k2OS/NoWaterNoNo/README.md

<h1>No Water, No No</h1>
See https://labitat.dk/wiki/No_Water_No_No for more information.

Eagle/ contains eagle files for the PCB

OpenSCAD/ contains the OpenSCAD drawings for the mounting brackets for the nodes + the battery compartment.

NoWaterNoNo/ contains the software for the nodes.
