k2OS/NoWaterNoNo/(list of files, cad)

Other CAD files:
OpenSCAD/nowaterholder_v4.scad
OpenSCAD/nowaterholder_v5.scad
