k2OS/NoWaterNoNo/Eagle/NoWaterNoNo.brd

## EAGLE design Eagle/NoWaterNoNo.brd (2014-10-13)

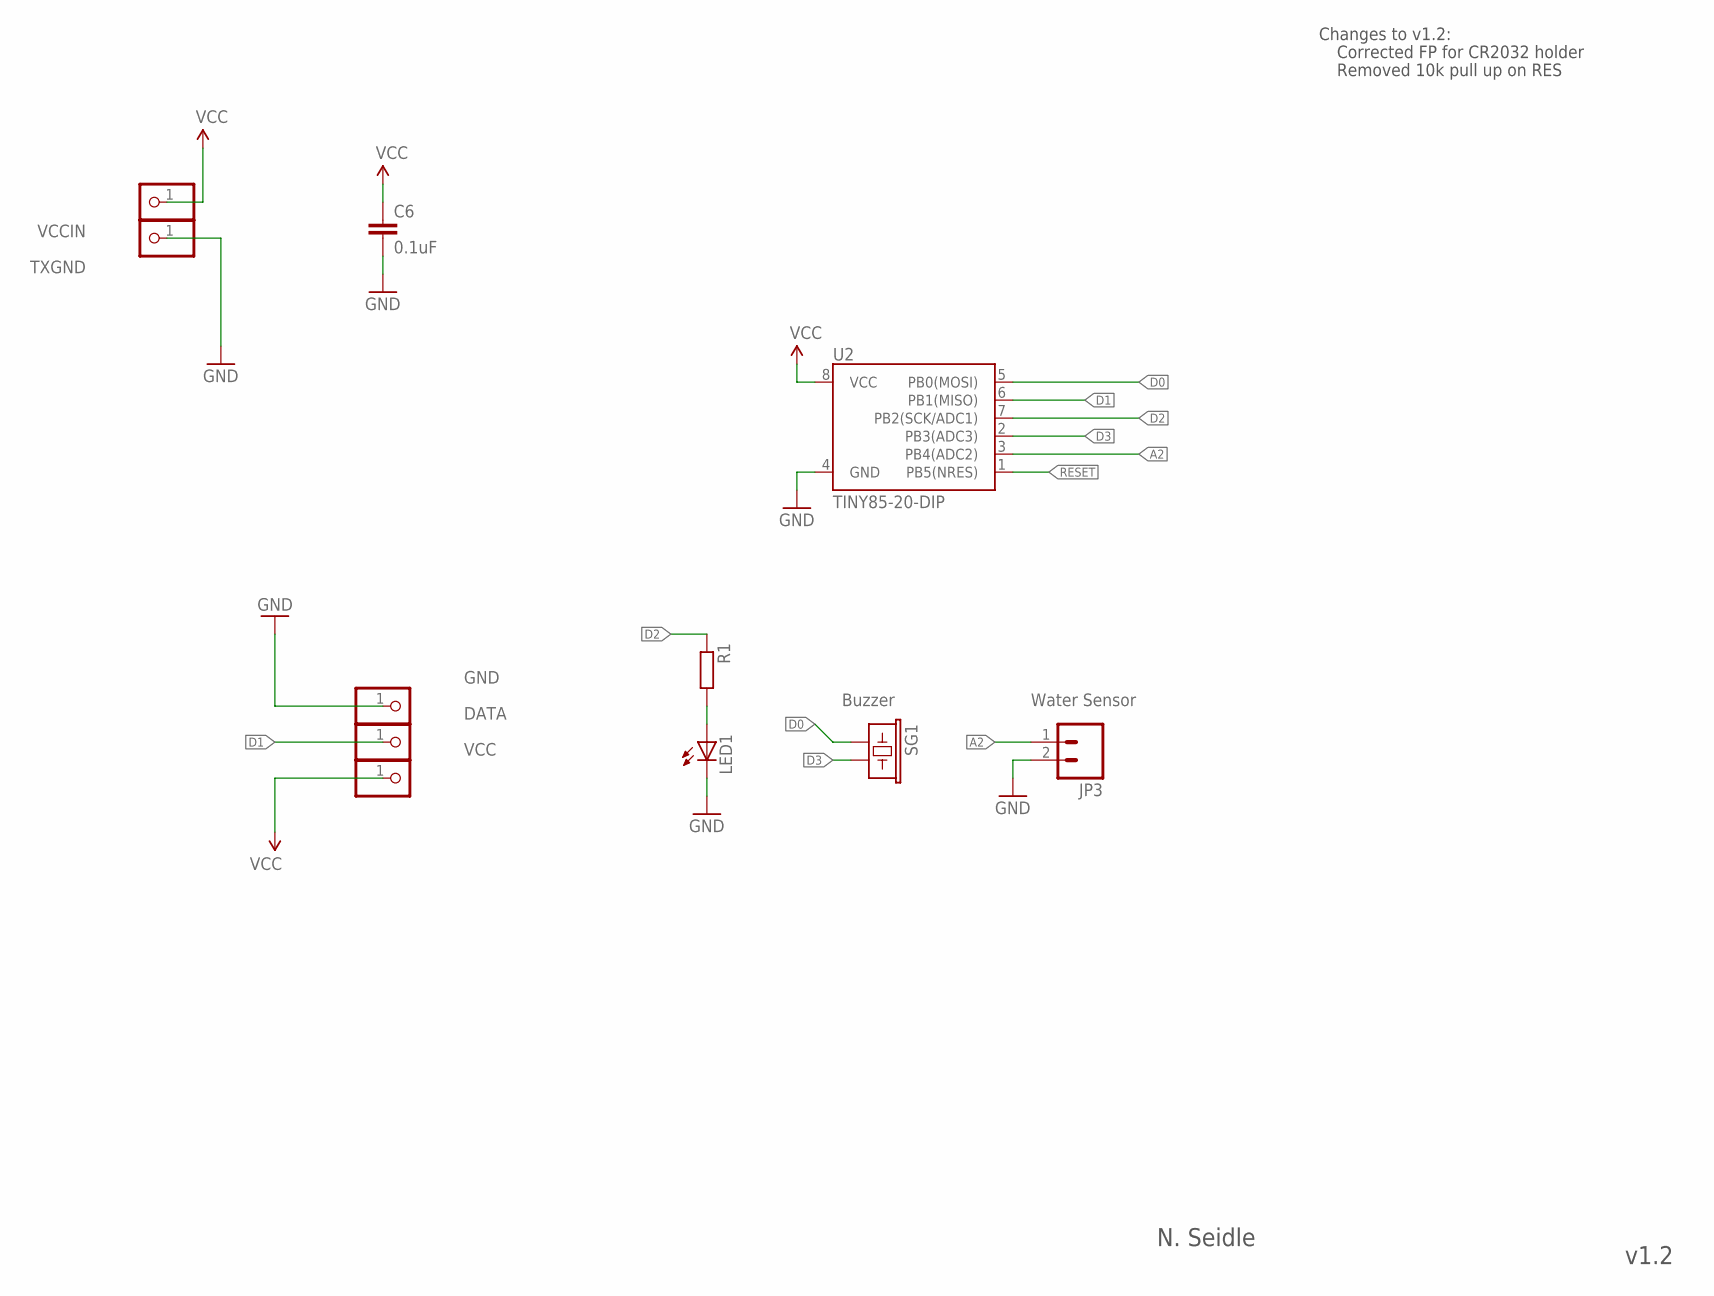
[picture p1: schematic NoWaterNoNo.sch]

Parts:
C6: 0.1uF; CAP-PTH-SMALL2
DATA: PINHD-1X1; 1X01
GND: PINHD-1X1; 1X01
JP3: Water Sensor; 1X02
LED1: LED5MM
R1: R-EU_0204/2V; 0204V
SG1: Buzzer; BUZZER-12MM
TXGND: PINHD-1X1; 1X01
U2: TINY85-20-DIP; DIP08
VCC: PINHD-1X1; 1X01
VCCIN: PINHD-1X1; 1X01

Connections:
A2: JP3.1, U2.3 (PB4(ADC2))
D0: SG1.+ (1), U2.5 (PB0(MOSI))
D1: DATA.1, U2.6 (PB1(MISO))
D2: R1.1, U2.7 (PB2(SCK/ADC1))
D3: SG1.- (2), U2.2 (PB3(ADC3))
GND: C6.2, GND.1, JP3.2, LED1.K (C), TXGND.1, U2.4 (GND)
unnamed: LED1.A, R1.2
RESET: U2.1 (PB5(NRES))
VCC: C6.1, U2.8 (VCC), VCC.1, VCCIN.1

Notes on the sheet:
N. Seidle
Changes to v1.2:
Corrected FP for CR2032 holder
Removed 10k pull up on RES
v1.2

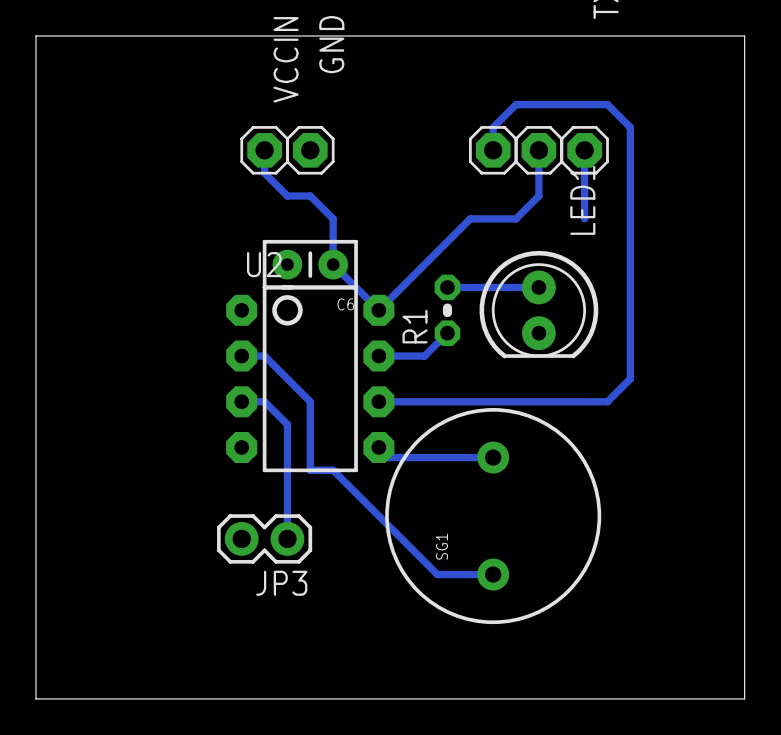
[picture p2: board NoWaterNoNo.brd from above]

Board: 2 copper layers, 39.4 x 36.8 mm, 11 parts (0 on the bottom side), 8 nets.
