k2OS/NoWaterNoNo/(commit log)

2014-04-14 Added eagle files
    [NoWaterNoNo.brd, NoWaterNoNo.sch]
2014-09-04 Adding OpenSCAD drawings
    [batterycompartment.scad, nowaterholder_v4.scad]
2014-09-04 adding new version of node mount
    [nowaterholder_v5.scad]
2014-09-04 Typo in scad-file
    [nowaterholder_v5.scad]
2014-09-04 Eagle: BRD and SCH files from test branch were more up to date than master.
    [NoWaterNoNo.brd, NoWaterNoNo.sch]
2014-10-13 Changed board layout. Buzzer, radio and sensor have changed pin assignments.
    [NoWaterNoNo.brd, NoWaterNoNo.sch]
2014-10-13 Added new slimmer version of PCB-holder.
    [nowaterholder_v6.scad]
2014-10-13 Changed board layouts once again. Changes made to Arduino code as well.
    [NoWaterNoNo.brd, NoWaterNoNo.sch]
